faizdaffa/Fuzzy-PID-Avoidance-Obstacle/ipynb/tes_result.txt

0.00,-0.14
0.00,-0.13
0.00,1.84
0.00,2.64
0.00,1.60
0.00,-0.45
0.00,-1.63
0.00,-1.52
0.00,-0.01
0.00,1.48
0.00,1.86
0.00,1.42
0.00,0.65
0.00,-0.36
0.00,-0.50
0.00,0.17
0.00,0.70
0.00,0.46
0.00,0.81
0.00,1.01
0.00,0.08
0.00,-0.03
0.00,-0.15
0.00,-0.35
0.00,-0.03
0.00,0.56
0.00,0.69
0.00,0.48
0.00,0.35
0.00,0.55
0.00,0.74
0.00,0.32
0.00,-0.03
-90.00,-0.45
-90.00,-1.02
-90.00,-3.46
-90.00,-8.65
-90.00,-15.30
-90.00,-22.43
-90.00,-29.59
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
