faizdaffa/Fuzzy-PID-Avoidance-Obstacle/docs/Repositori/LAMPIRAN.pdf

LAMPIRAN

Lampiran: Proses pembuatan Mobile Robot menggunakan PCB


1. Proses etching PCB


2. Proses pemotongan PCB


3. Pengeboran PCB | 4. Pemasangan komponen


5. Penyolderan komponen 6. Hasil bottom layer PCB

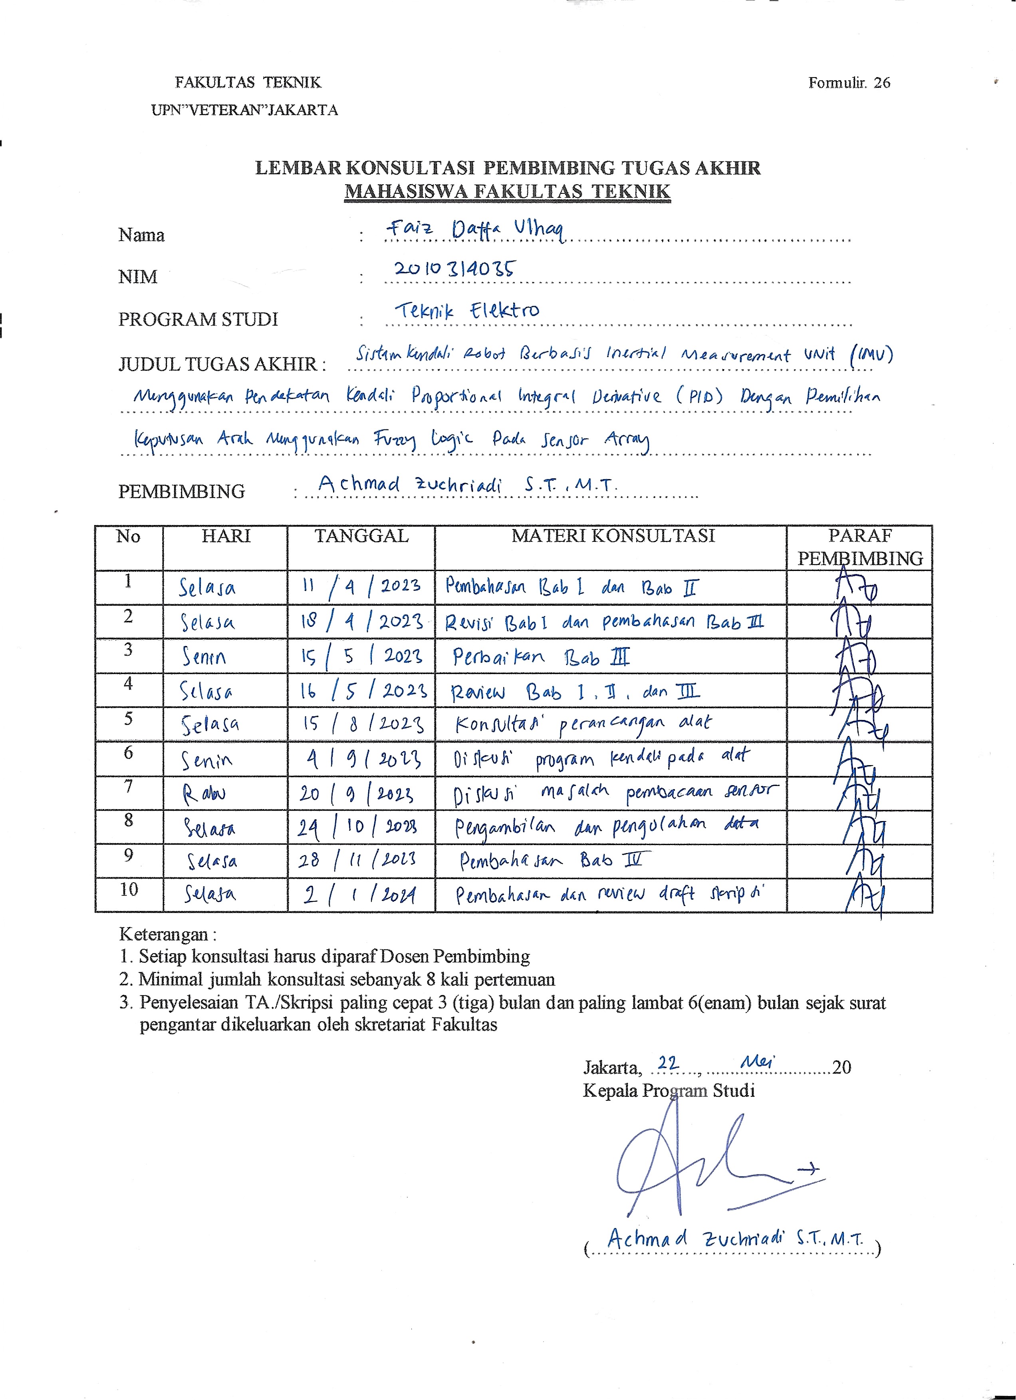
[picture p88: page 3]
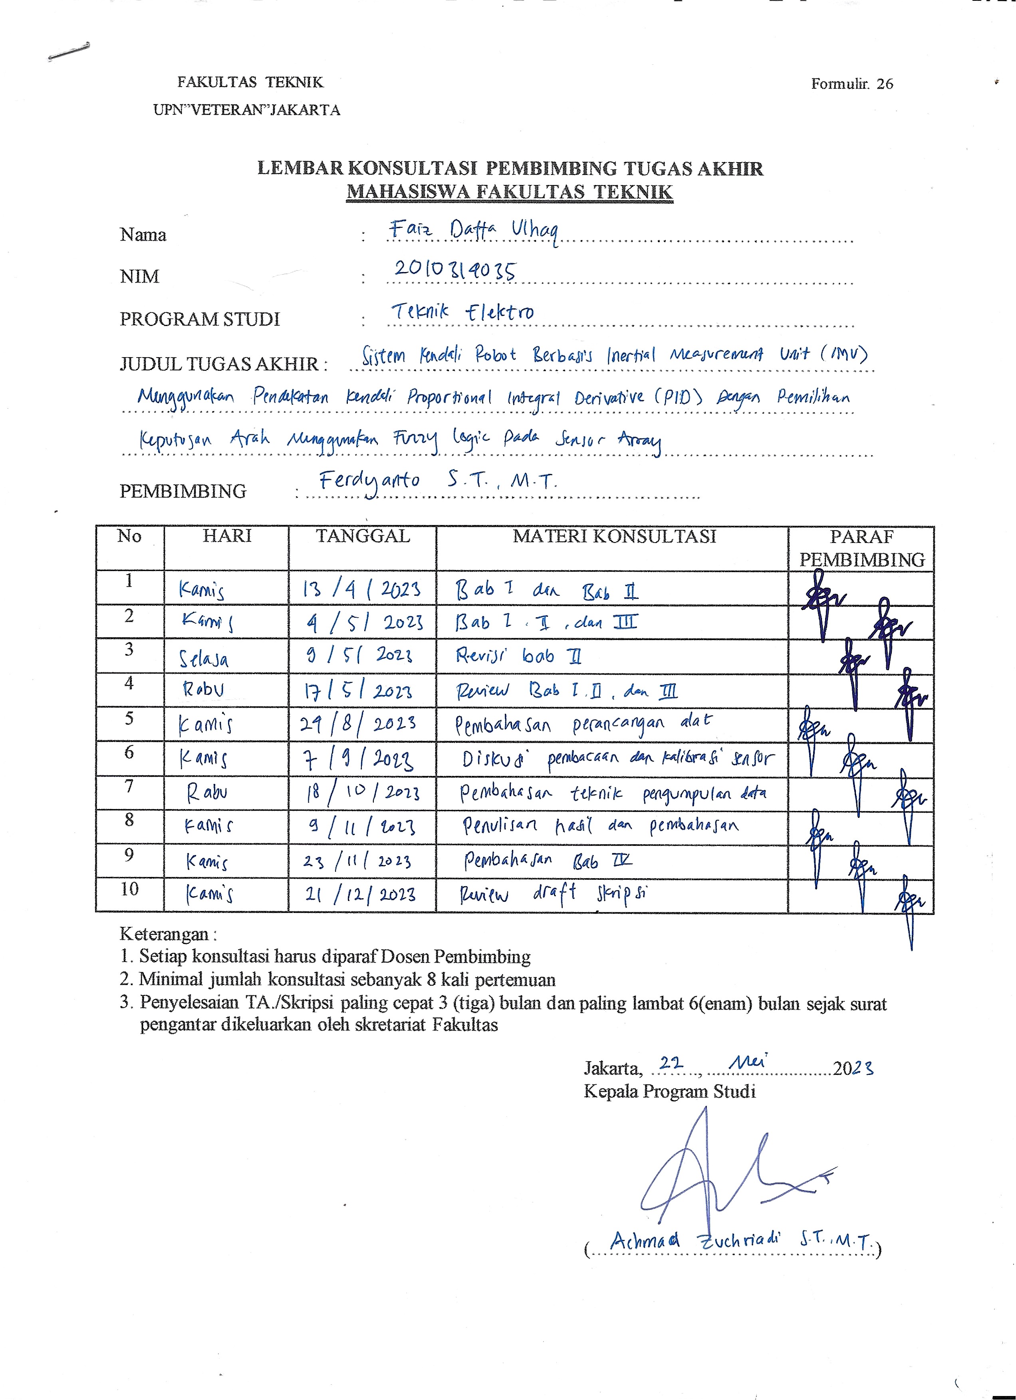
[picture p89: page 4]
