faizdaffa/Fuzzy-PID-Avoidance-Obstacle/docs/ALL/SCAN BEBAS PLAGIARISM.pdf

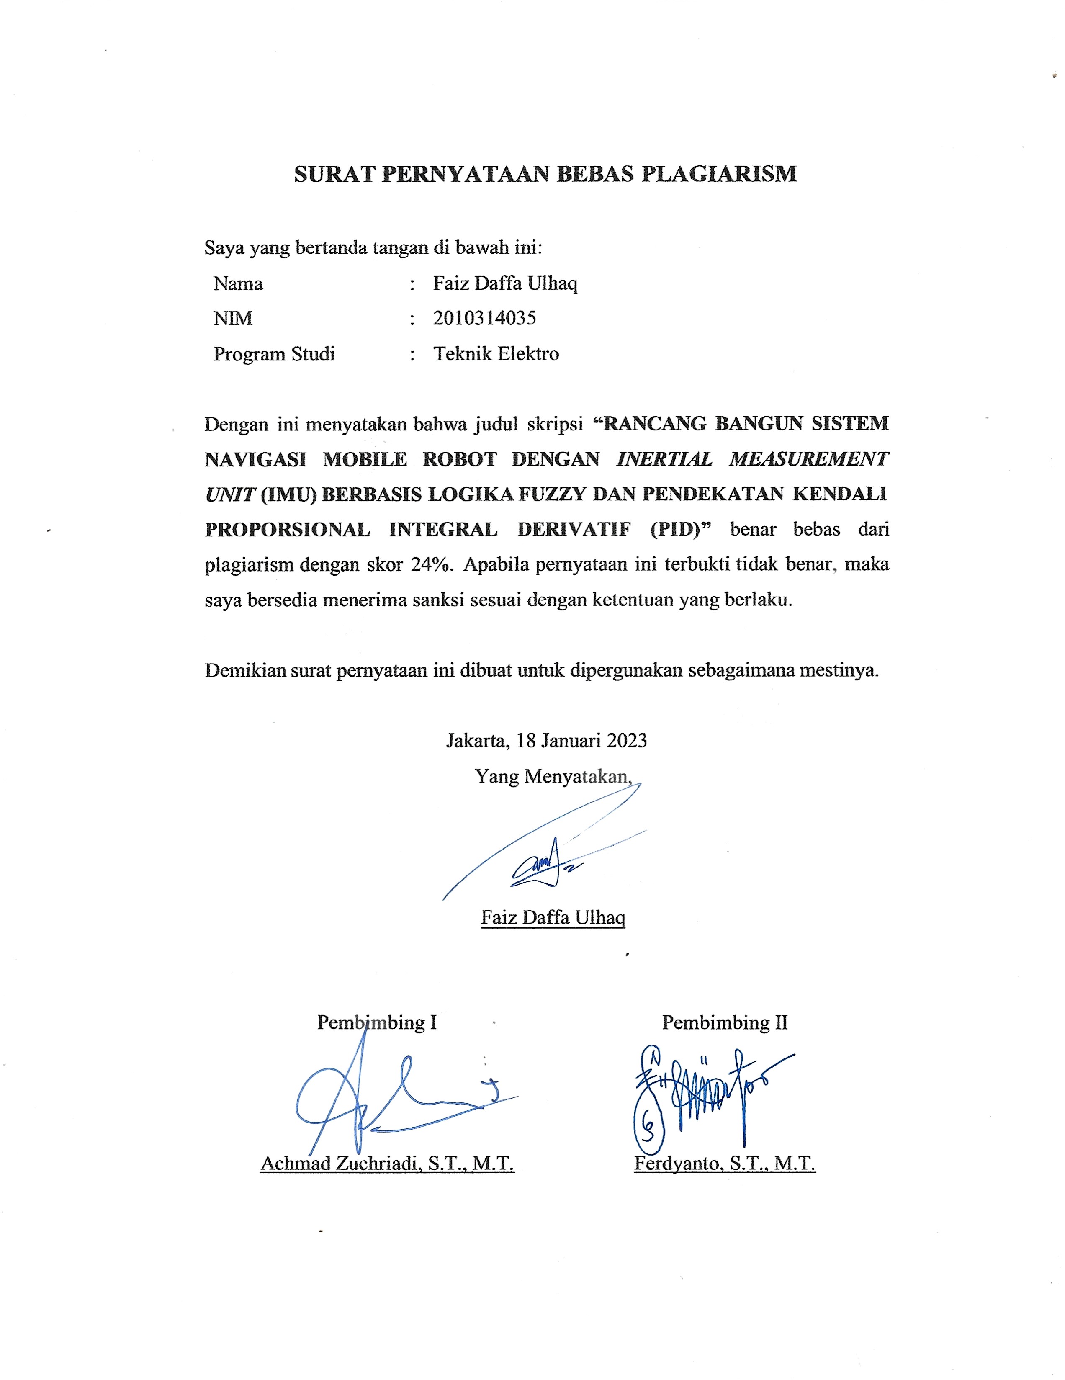
[picture p105: page 1]
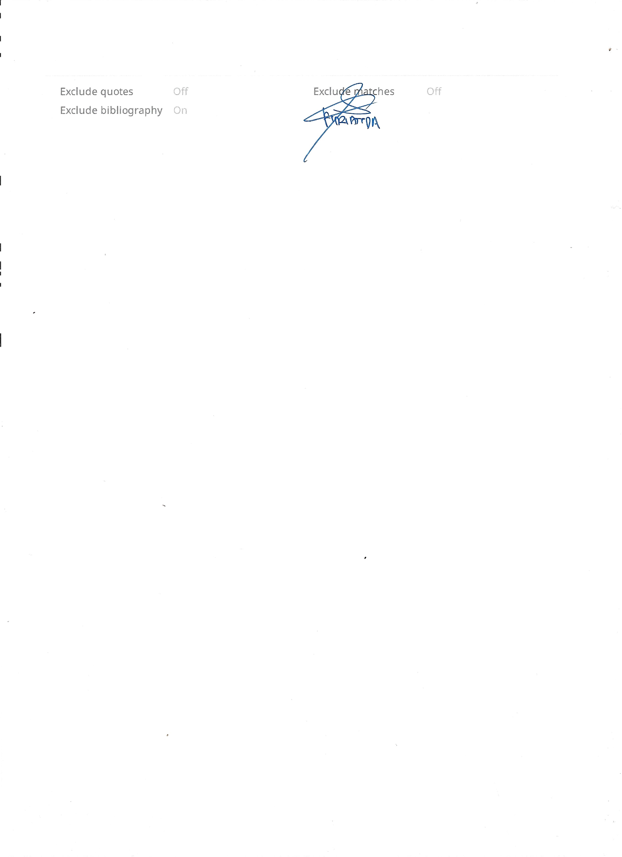
[picture p106: page 2]
