faizdaffa/Fuzzy-PID-Avoidance-Obstacle/ipynb/tes_result2.txt

0.00,0.41
0.00,-0.43
0.00,-3.36
0.00,-2.79
0.00,-0.14
0.00,2.81
0.00,3.33
0.00,1.63
0.00,-0.78
0.00,-2.43
0.00,-2.05
0.00,0.33
0.00,2.25
0.00,3.02
0.00,1.55
0.00,-0.59
0.00,-2.08
0.00,-2.17
0.00,-0.29
0.00,1.62
0.00,2.41
0.00,1.75
0.00,0.41
0.00,-1.24
0.00,-1.38
0.00,-0.37
0.00,1.00
0.00,1.66
0.00,1.42
0.00,0.44
0.00,-0.72
0.00,-1.55
0.00,-0.94
0.00,0.40
0.00,1.98
0.00,2.96
0.00,1.41
0.00,-1.01
0.00,-2.69
0.00,-1.97
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
