faizdaffa/Fuzzy-PID-Avoidance-Obstacle/(commit log)

2023-12-10 tuning PID
    [tabel data.xlsx]
2023-12-14 tuning pid done
2024-01-04 ayo sidang
    [tabel data.xlsx]
